wnearhood/espnow-candles-public/docs/STATUS.md

# Project status and warranty

**No warranty, stated or implied.** It worked on my machine with my setup.
Your candles, parts, radios and network will be different. Build and use it
at your own risk; see [LICENSE](../LICENSE).

**Status: mostly feature complete.** It runs day to day in my house. I have a
few features I'd still like to add, and things may change without notice.

**100% AI-generated.** All firmware, scripts, 3D model generators and the
schematic were written by Claude (Anthropic). I directed the design, built and
tested the hardware, and ran it in my home; I did not hand-write the code.
Review it before trusting it with anything that matters.

**Personal use only.** No selling kits, converted candles, printed parts or
conversion services. See [LICENSE](../LICENSE).

## Safety

- These run on batteries inside something that looks like a candle. Check
  your wiring with a meter before inserting batteries.
- Never connect USB with batteries installed (remove JP1 first; see the
  [schematic](schematic.svg)).
- Battery sensing is wired for 2×AA NiMH. Other packs need a voltage divider.
