wnearhood/espnow-candles-public/candle_insert/deck_v5_iso.png

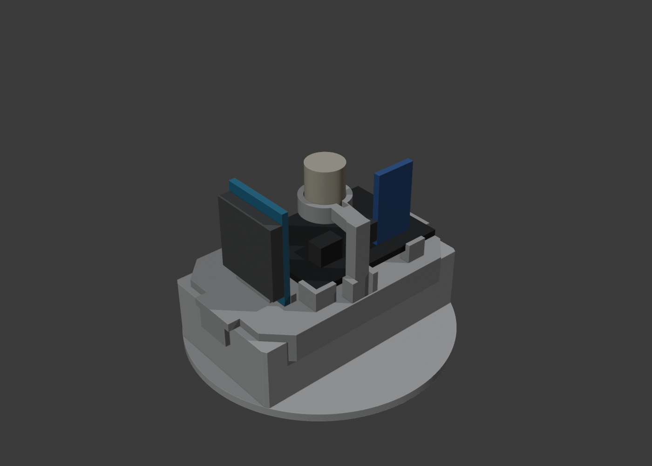
candle_insert/deck_v5_iso.png
