wnearhood/espnow-candles-public/candle_insert/deck_v5_side.png

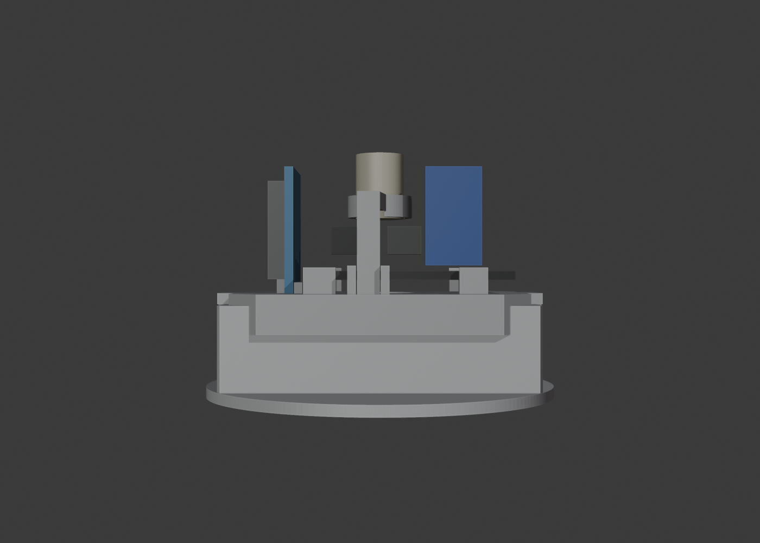
candle_insert/deck_v5_side.png
