wnearhood/espnow-candles-public/candle_insert/deck_v5_top.png

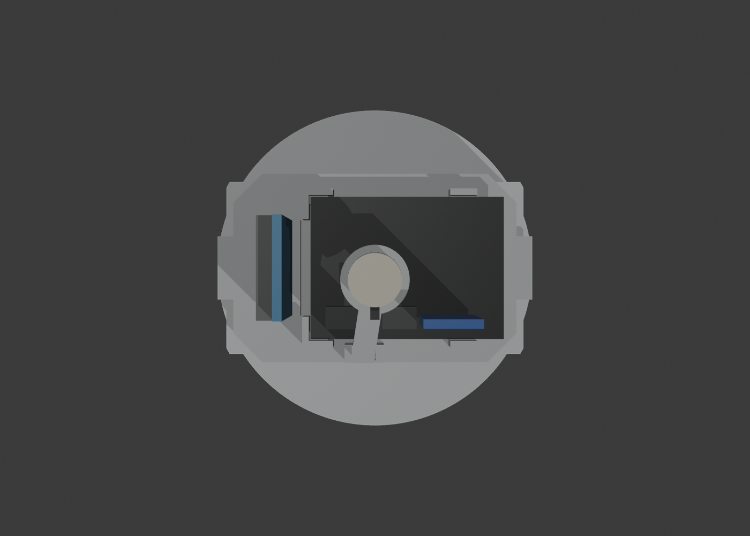
candle_insert/deck_v5_top.png
