wnearhood/espnow-candles-public/hub_house/preview_iso_usb_end.png

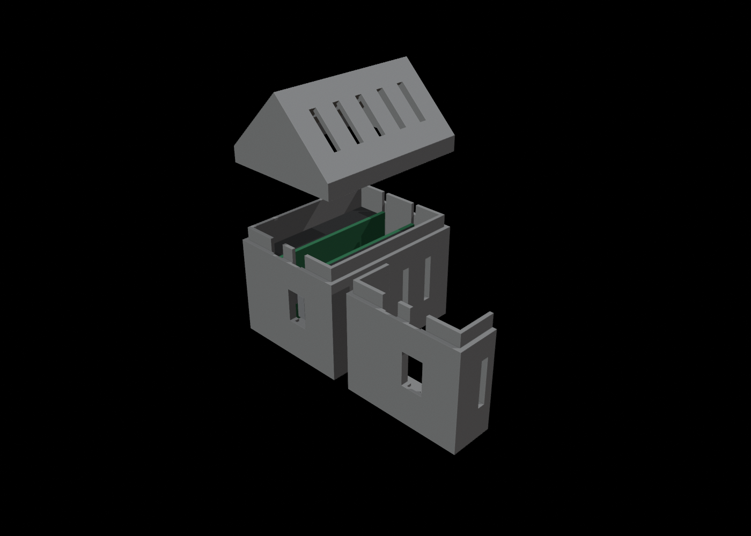
hub_house/preview_iso_usb_end.png
