wnearhood/espnow-candles-public/3d_models/candle_deck_v5.stl

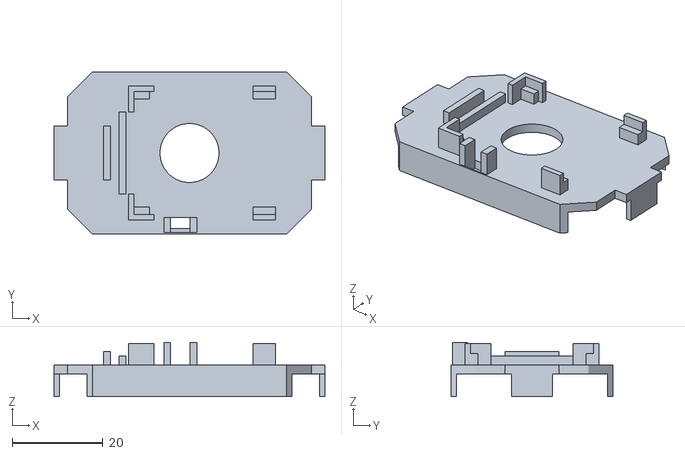
[picture p5: CAD file, 2026-10-19]
3d_models/candle_deck_v5.stl
59.8 x 35.8 x 12.0
