wnearhood/espnow-candles-public/3d_models/hub_house_body.stl

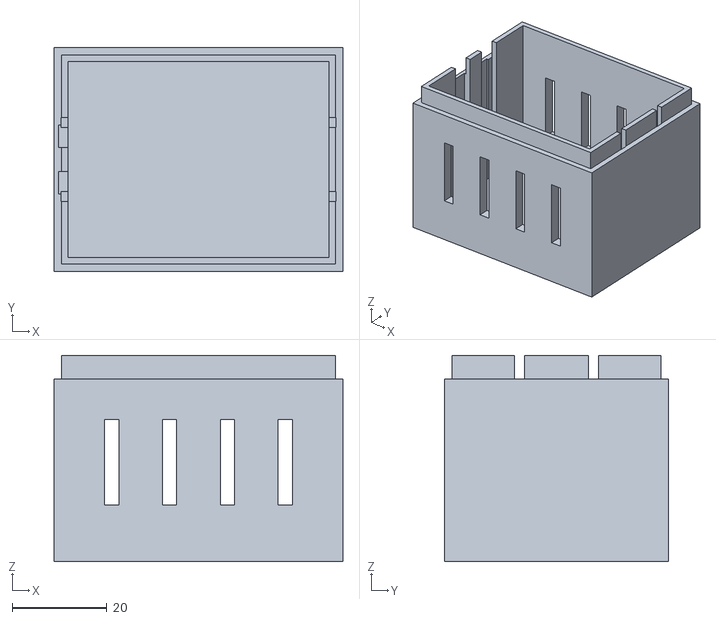
[picture p6: CAD file, 2026-10-19]
3d_models/hub_house_body.stl
60.9 x 47.2 x 43.5
