wnearhood/espnow-candles-public/3d_models/hub_house_roof.stl

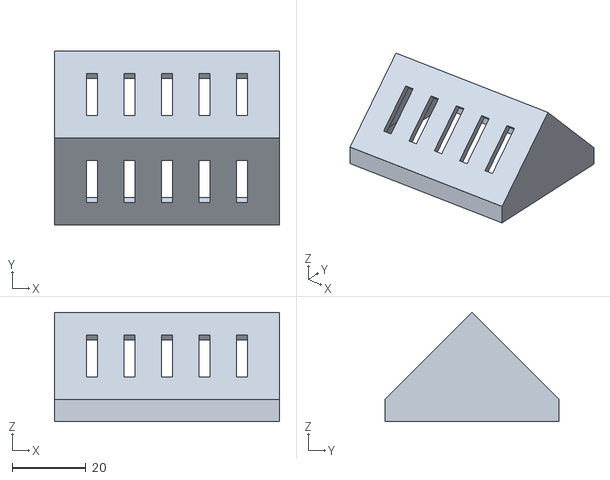
[picture p7: CAD file, 2026-10-19]
3d_models/hub_house_roof.stl
60.9 x 47.2 x 29.5
