wnearhood/espnow-candles-public/3d_models/candle_led_arm_v1.stl

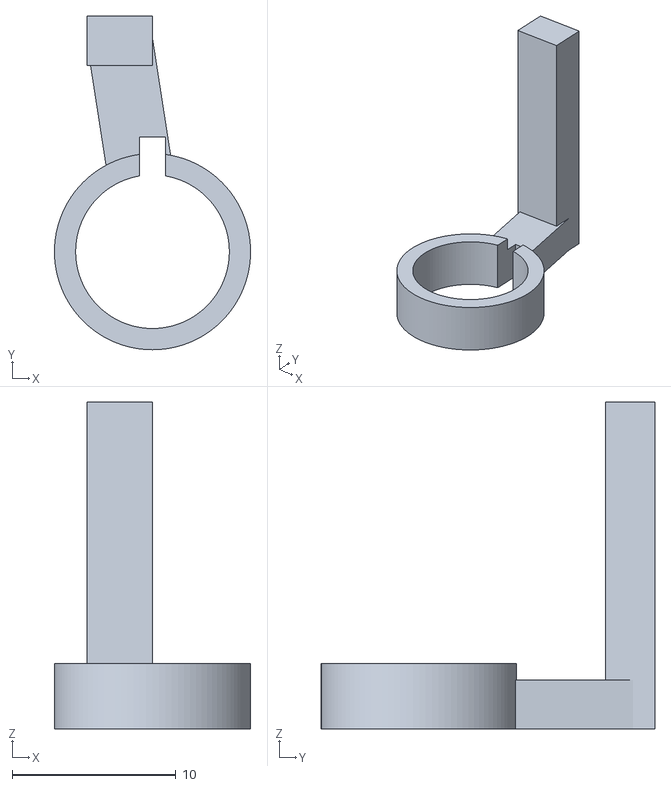
[picture p8: CAD file, 2026-10-19]
3d_models/candle_led_arm_v1.stl
12.0 x 20.4 x 20.0
